HexabitzPlatform/HF091CBU-Hardware/README.md

# HF091CBU-Hardware
Hexabitz STM32F091CBU6 DevKit Hardware Design
