HexabitzPlatform/HF091CBU-Hardware/Released/BOM/HF091CBU.xlsx

 |  | www.hexabitz.com info@hexabitz.com |  | Bill Of Materials
Customer | Hexabitz | Revision | 0
Project | Hexabitz Modules | Date | 2024-05-27
Board | STM32F091CBU6 DevKit | Notes
Designator | Description | Manufacturer Part Number | Manufacturer | Octopart Url | Quantity
BOOT, RESET | Switch Tactile N.O. SPST Round Button PC Pins 0.05A 12VDC 100000Cycle 1.27N Thru-Hole Bulk | PTS645SL43LFS | C&K Components | https://octopart.com/pts645sl43lfs-c%26k+components-7881901?r=sp | 2
SWD | Connector Header Through Hole, Right Angle 5 position 0.100" (2.54mm) | M20-9960245 | Harwin | https://octopart.com/m20-9960245-harwin-14865948?r=sp | 1
JP_L, JP_R | Connector Header Through Hole 20 position 0.100" (2.54mm) | M20-9992046 | Harwin | https://octopart.com/m20-9992046-harwin-2627752 | 2
USB_MICRO | USB Connector, 5 Contact(s), Female, Right Angle, Surface Mount Terminal, Locking, Receptacle | 629105136821 | Wurth Elektronik | https://octopart.com/629105136821-wurth+elektronik-19991173?r=sp | 1
R3 | RES SMD 0.0OHM JUMPER 1/10W 0603 | RC0603JR-070RL | YAGEO [VR] | https://octopart.com/rc0603jr-070rl-yageo-1241539?r=sp | 1
R4, R5 | Thick Film Resistors - SMD 0603 1/10W 1% 27R T/R-5000 | 0603WAF270JT5E | Royal Ohm | https://octopart.com/0603waf270jt5e-royal+ohm-127860643?r=sp | 2
R1 | Thick Film Resistors - SMD 0603 270 Ohm 5% Tol | ERJ-3GEYJ271V | Panasonic | https://octopart.com/erj-3geyj271v-panasonic-55560546?r=sp | 1
R2, R10, R11 | RES 10K Ohm 5% 0603 | CRCW060310K0JNEB | Vishay | https://octopart.com/crcw060310k0jneb-vishay-46603269 | 3
C13, C14 | CAP CER 47pF 10% X7R 0603 | VJ0603A470JXACW1BC | Vishay | https://octopart.com/vj0603a470jxacw1bc-vishay-39475596?r=sp | 2
C5, C17 | Multilayer Ceramic Capacitor, 0.01 uF, 50 V, ± 10%, X7R, 0603 [1608 Metric] | C0603C103K5RACTU | KEMET | https://octopart.com/c0603c103k5ractu-kemet-133094?r=sp | 2
C1, C6, C7, C8, C9, C11, C12, C15, C16, C18 | CAP CER 0.1 UF 10% X7R 0603 | C0603C104K8RACTU | KEMET | https://octopart.com/c0603c104k8ractu-kemet-145075?r=sp&s=9bS9ASSwSEqMCE9KBEQZ0g | 10
C2 | CAP CER 1 UF 16V X7R 0805 | CC0805KKX7R7BB105 | YAGEO [VA] | https://octopart.com/cc0805kkx7r7bb105-yageo-8376555?r=sp | 1
C10 | CAP CER 4.7uF 10% X7R 0805 | 10TPU4R7MSI | Panasonic | https://octopart.com/10tpu4r7msi-panasonic-29487748?r=sp | 1
C3, C4 | CAP TANT 4.7 UF 10V 20% 0805 | 10TPU4R7MSI | Panasonic | https://octopart.com/10tpu4r7msi-panasonic-29487748?r=sp | 2
FB1, FB2 | Ind chip Bead Multi-Layer 30 ohms 25% 100MHZ Ferrite 1,5A 0603Punched paper T/R | MMZ1608Y300BTA00 | TDK | https://octopart.com/mmz1608y300bta00-tdk-7906990?r=sp | 2
D1 | Red 0603 130° Clear 54 mcd 2 V Surface Mount ChipLED | VLMS1300-GS08 | Vishay | https://octopart.com/vlms1300-gs08-vishay-21709201?r=sp&s=0nXJNjGsSbWwqfqWlZv0EA | 1
D4 | Diode Switching 1KV 1A 2-Pin SOD-123FL T/R | FSM17PL-TP | MCC | https://octopart.com/fsm17pl-tp-mcc-57606818?r=sp | 1
U1 | MCU 32-bit ARM Cortex M0 RISC 128KB Flash 2.5V/3.3V 48-Pin UFQFPN EP Frame | STM32F091CBU6 | STMicroelectronics | https://octopart.com/stm32f091cbu6-stmicroelectronics-51988677?r=sp | 1
U2 | USB-to-UART 1-CH 256Byte FIFO 5V 32-Pin QFN EP Check availability | FT232RQ |  | https://www.alibaba.com/product-detail/Ft232hl-Ft232h-Ft232-Ftdi-Qfp48-Usb_1600809369606.html | 1
X1 | 8,0000MHZ 33pF SMD MURATA Resonators | CSTNE8M00G550000R0 | Murata | https://octopart.com/cstne8m00g550000r0-murata-91406934?r=sp | 1
