HexabitzPlatform/HF091CBU-Hardware/Documintation/HF091CBU_Schematic.pdf

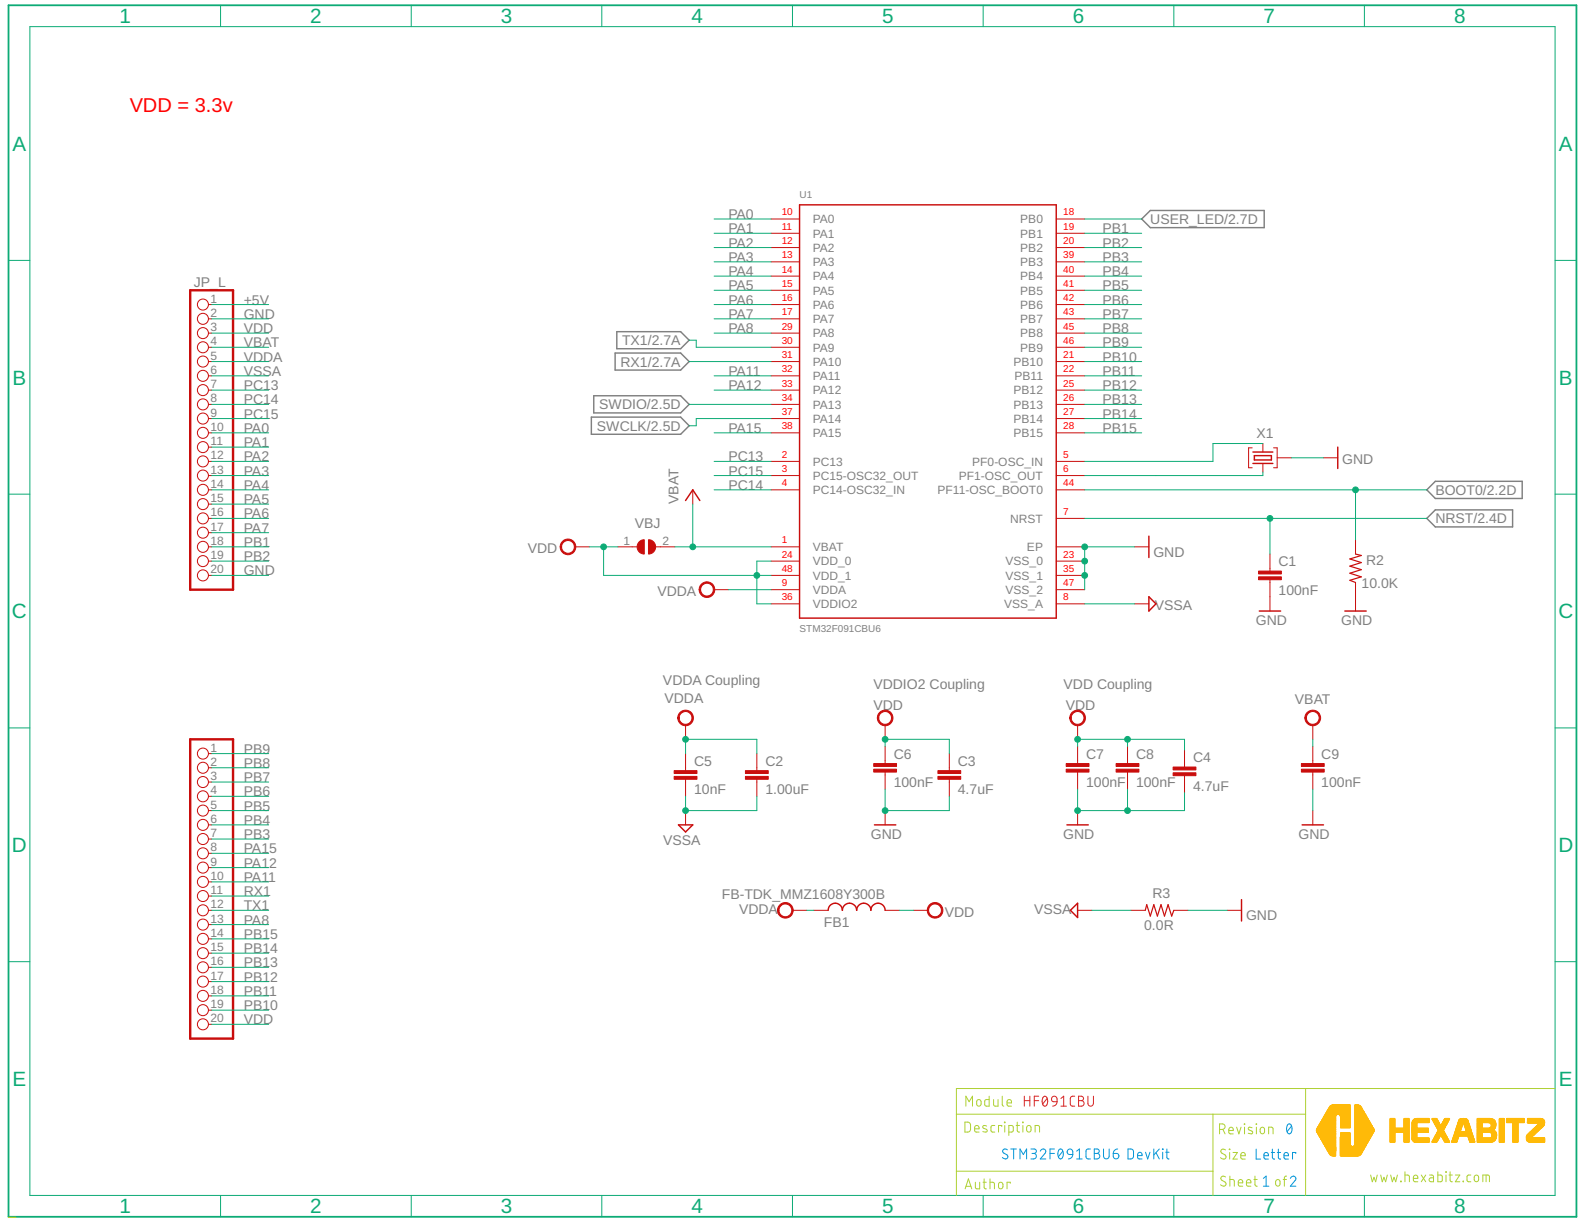
[picture p1: page 1]

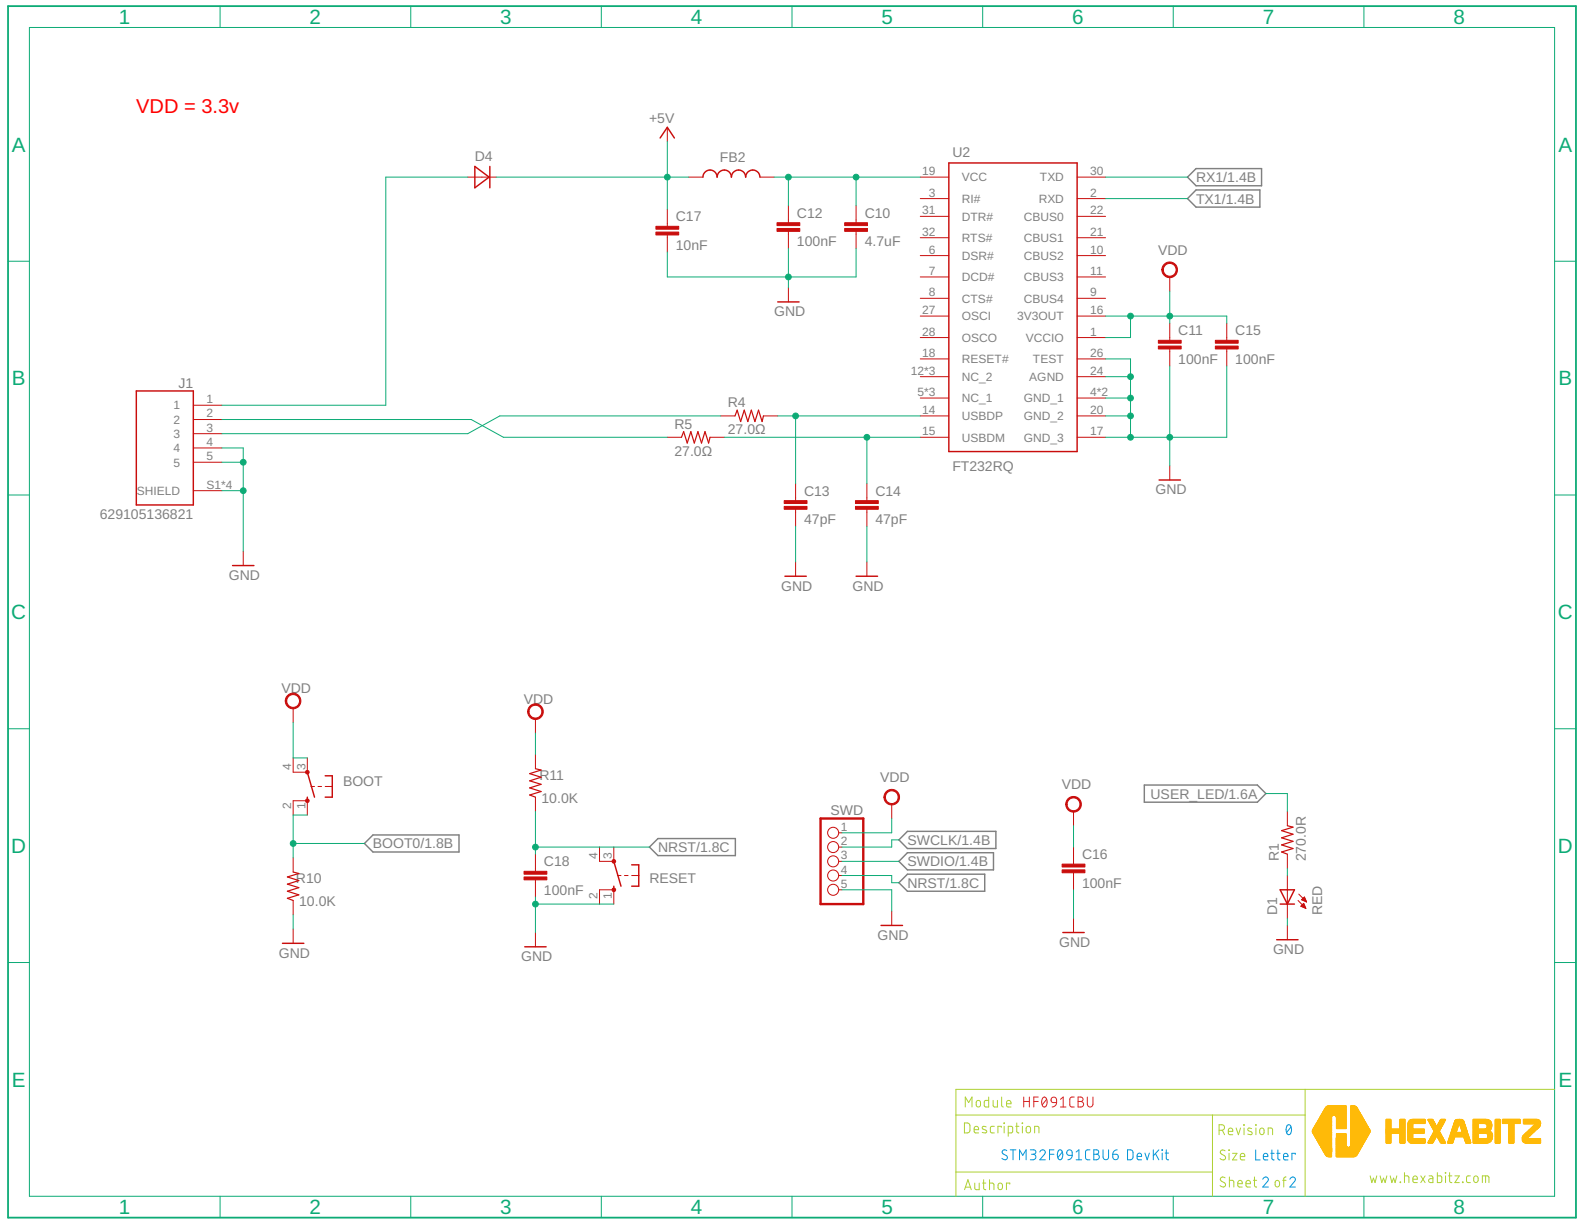
[picture p2: page 2]

VDD = 3.3v
