HexabitzPlatform/HF091CBU-Hardware/Design/HF091CBU.brd

## EAGLE design Design/HF091CBU.brd (2024-09-10)

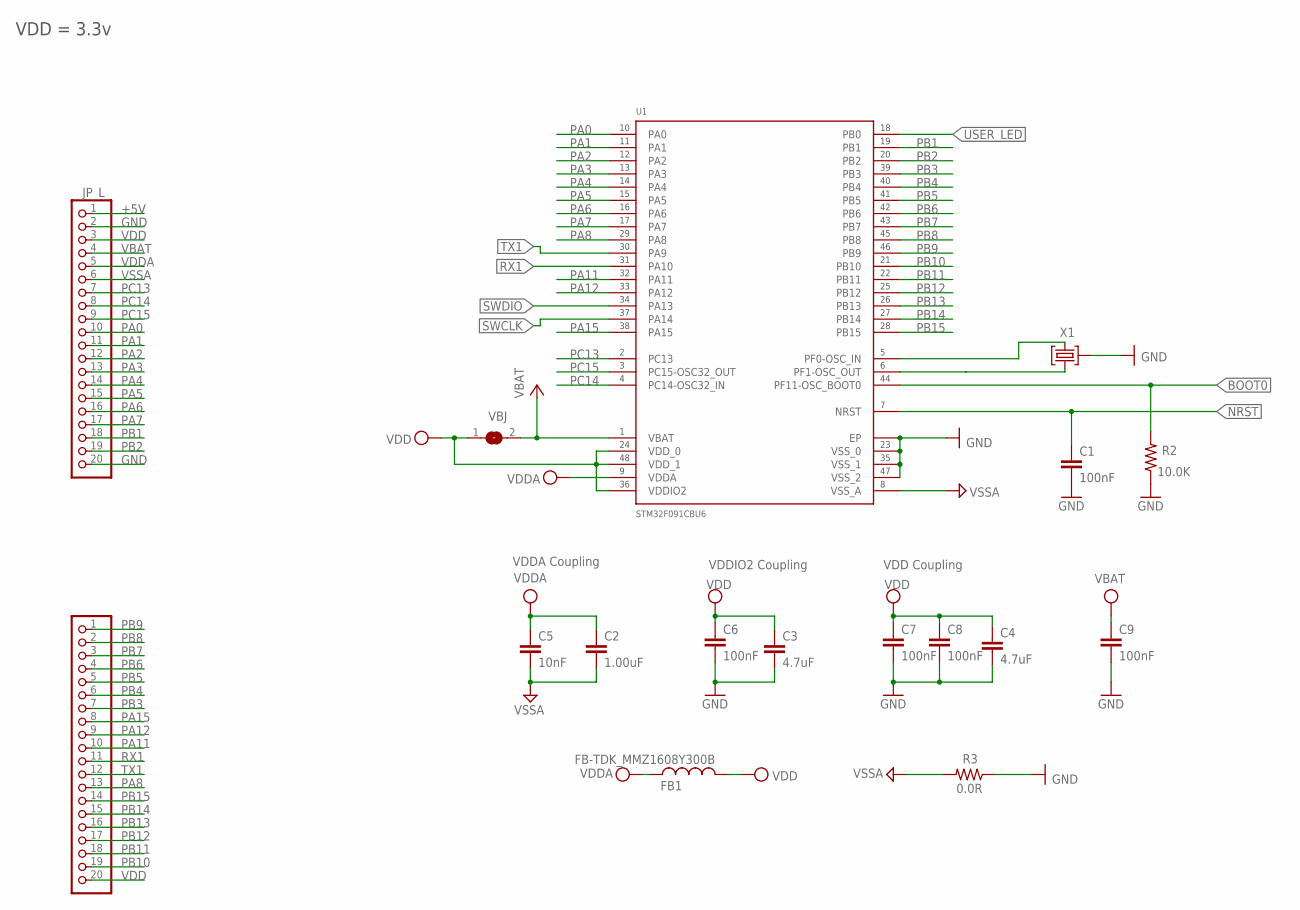
[picture p3: schematic HF091CBU.sch, sheet 1]

Parts:
C1, C6, C8: 100nF; C-0603; TOLERANCE 10%; VOLTAGE_RATING 10V; MPN C0603C104K8RACTU
C2: 1.00uF; C-0805
C3, C4: 4.7uF; C-0805
C5: 10nF; C-0603; TOLERANCE 10%; VOLTAGE_RATING 50V; MPN C0603C103K5RACTU
C7: 100nF; C-0603; TOLERANCE 10%; VOLTAGE_RATING 10; MPN C0603C104K8RACTU
C9: 100nF; C-0603; TOLERANCE 10V; VOLTAGE_RATING 10%; MPN C0603C104K8RACTU
FB1: FB-TDK_MMZ1608Y300B; FB-0603; MPN MMZ1608Y300B
JP_L: PINHD-1X20; 1X20
JP_R: PINHD-1X20; 1X20
R2: 10.0K; R-0603; TOLERANCE 5%; MPN CRCW060310K0JNEB
R3: 0.0R; R-0603; MPN RC0603JR-070RL
U1: STM32F091CBU6
VBJ: SJ
X1: XTALL_CSTCE8M00G52

Connections:
+5V: JP_L.1; also elsewhere on the board
BOOT0: R2.2, U1.P$44 (PF11-OSC_BOOT0); also elsewhere on the board
GND: C1.2, C3.2, C4.2, C6.2, C7.2, C8.2, C9.2, JP_L.2, JP_L.20, R2.1, R3.1, U1.EP, U1.P$23 (VSS_0), U1.P$35 (VSS_1), U1.P$47 (VSS_2), X1.P$2 (2); also elsewhere on the board
unnamed: U1.P$5 (PF0-OSC_IN), X1.P$1 (1)
unnamed: U1.P$6 (PF1-OSC_OUT), X1.P$3 (3)
NRST: C1.1, U1.P$7 (NRST); also elsewhere on the board
PA0: JP_L.10, U1.P$10 (PA0)
PA1: JP_L.11, U1.P$11 (PA1)
PA2: JP_L.12, U1.P$12 (PA2)
PA3: JP_L.13, U1.P$13 (PA3)
PA4: JP_L.14, U1.P$14 (PA4)
PA5: JP_L.15, U1.P$15 (PA5)
PA6: JP_L.16, U1.P$16 (PA6)
PA7: JP_L.17, U1.P$17 (PA7)
PA8: JP_R.13, U1.P$29 (PA8)
PA11: JP_R.10, U1.P$32 (PA11)
PA12: JP_R.9, U1.P$33 (PA12)
PA15: JP_R.8, U1.P$38 (PA15)
PB1: JP_L.18, U1.P$19 (PB1)
PB2: JP_L.19, U1.P$20 (PB2)
PB3: JP_R.7, U1.P$39 (PB3)
PB4: JP_R.6, U1.P$40 (PB4)
PB5: JP_R.5, U1.P$41 (PB5)
PB6: JP_R.4, U1.P$42 (PB6)
PB7: JP_R.3, U1.P$43 (PB7)
PB8: JP_R.2, U1.P$45 (PB8)
PB9: JP_R.1, U1.P$46 (PB9)
PB10: JP_R.19, U1.P$21 (PB10)
PB11: JP_R.18, U1.P$22 (PB11)
PB12: JP_R.17, U1.P$25 (PB12)
PB13: JP_R.16, U1.P$26 (PB13)
PB14: JP_R.15, U1.P$27 (PB14)
PB15: JP_R.14, U1.P$28 (PB15)
PC13: JP_L.7, U1.P$2 (PC13)
PC14: JP_L.8, U1.P$3 (PC14-OSC32_IN)
PC15: JP_L.9, U1.P$4 (PC15-OSC32_OUT)
RX1: JP_R.11, U1.P$31 (PA10); also elsewhere on the board
SWCLK: U1.P$37 (PA14); also elsewhere on the board
SWDIO: U1.P$34 (PA13); also elsewhere on the board
TX1: JP_R.12, U1.P$30 (PA9); also elsewhere on the board
USER_LED: U1.P$18 (PB0); also elsewhere on the board
VBAT: C9.1, JP_L.4, U1.P$1 (VBAT), VBJ.2
VDD: C3.1, C4.1, C6.1, C7.1, C8.1, FB1.2, JP_L.3, JP_R.20, U1.P$24 (VDD_0), U1.P$36 (VDDIO2), U1.P$48 (VDD_1), VBJ.1; also elsewhere on the board
VDDA: C2.1, C5.1, FB1.1, JP_L.5, U1.P$9 (VDDA)
VSSA: C2.2, C5.2, JP_L.6, R3.2, U1.P$8 (VSS_A)

Notes on the sheet:
VDDA Coupling
VDDIO2 Coupling
VDD Coupling
VDD = 3.3v

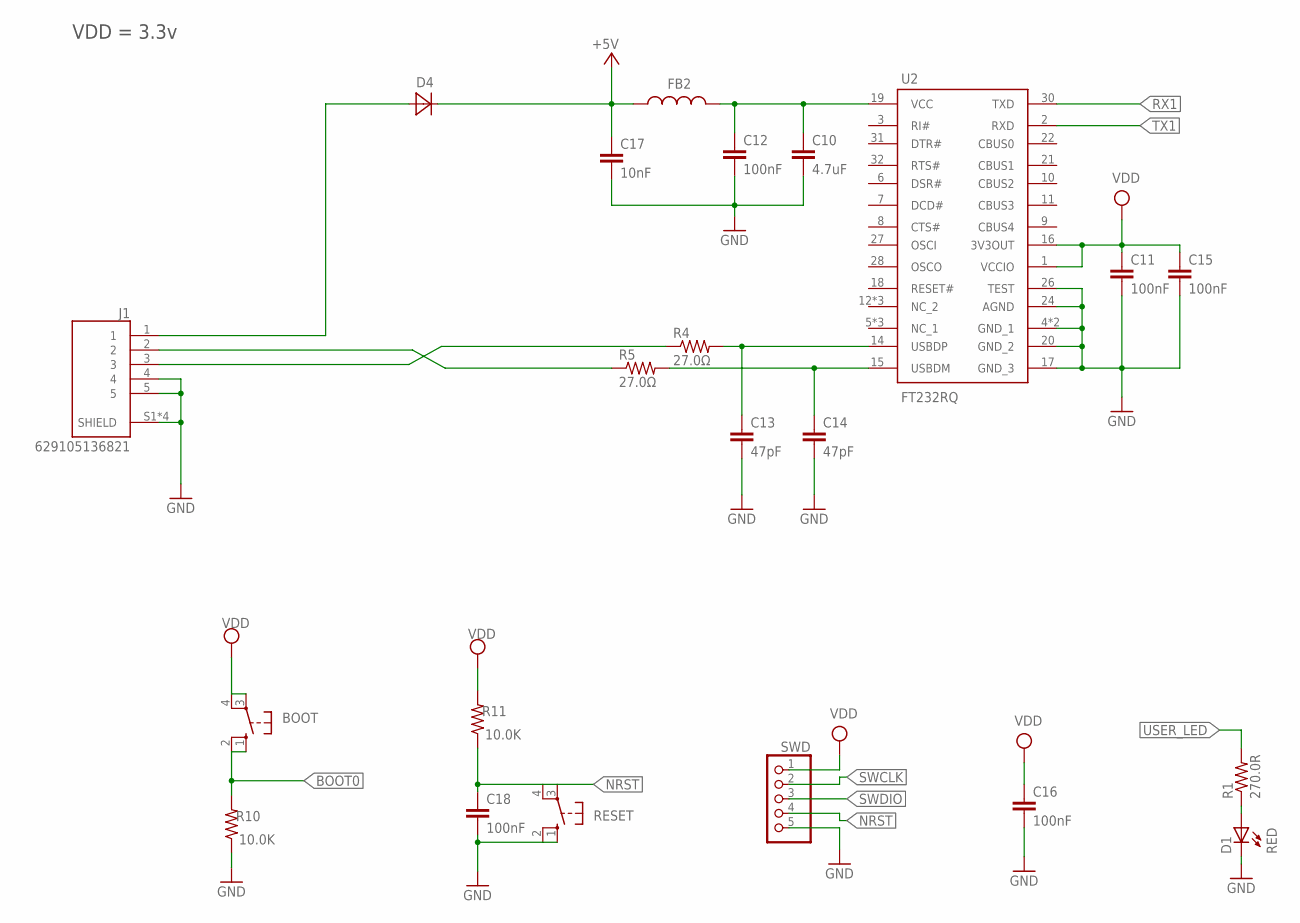
[picture p4: schematic HF091CBU.sch, sheet 2]

Parts:
BOOT: 10-XX; B3F-10XX
C10: 4.7uF; C-0805
C11, C12, C15: 100nF; C-0603; TOLERANCE ±10%; VOLTAGE_RATING 16.0 V; MPN 0603YC104K4T2A
C13, C14: 47pF; C-0603; TOLERANCE ±5%; VOLTAGE_RATING 50.0 V; MPN 06035A470JAT2A
C16, C18: 100nF; C-0603; TOLERANCE 10%; VOLTAGE_RATING 10V; MPN C0603C104K8RACTU
C17: 10nF; C-0603; TOLERANCE ±10%; VOLTAGE_RATING 16.0 V; MPN 0603YC104K4T2A
D1: RED; VLMS1300-GS08; MPN VLMS1300-GS08
D4: DIOD-SOD-123; SOD123
FB2: FB-TDK_MMZ1608Y300B; FB-0603; MPN MMZ1608Y300B
J1: 629105136821; WE_629105136821
R1: 270.0R; R-0603; TOLERANCE 1%; MPN RC0603FR-07270RL
R4, R5: 27.0Ω; R-0603; TOLERANCE ±1%; MPN CRCW060327R0FKEA
R10, R11: 10.0K; R-0603; TOLERANCE 5%; MPN RC0603JR-0710KL
RESET: 10-XX; B3F-10XX
SWD: PINHD-1X5/90; 1X05/90
TRIMBLE-LOGO1: HEXABITZ-LOGO_NO_BOTTOM_SPLIT
U2: FT232RQ; QFN50P500X500X90-33N

Connections:
+5V: C17.1, D4.2 (C), FB2.1; also elsewhere on the board
BOOT0: BOOT.1 (S), BOOT.2 (S1), R10.2; also elsewhere on the board
GND: C10.2, C11.2, C12.2, C13.2, C14.2, C15.2, C16.2, C17.2, C18.2, D1.C, J1.4, J1.5, J1.S1 (SHIELD), J1.S2 (SHIELD), J1.S3 (SHIELD), J1.S4 (SHIELD), R10.1, RESET.1 (S), RESET.2 (S1), SWD.5, U2.4 (GND_1), U2.17 (GND_3), U2.20 (GND_2), U2.24 (AGND), U2.26 (TEST), U2.33 (GND_1); also elsewhere on the board
unnamed: D4.1 (A), J1.1
unnamed: C10.1, C12.1, FB2.2, U2.19 (VCC)
unnamed: D1.A, R1.1
NRST: C18.1, R11.1, RESET.3, RESET.4 (P1), SWD.4; also elsewhere on the board
RX1: U2.30 (TXD); also elsewhere on the board
SWCLK: SWD.2; also elsewhere on the board
SWDIO: SWD.3; also elsewhere on the board
TX1: U2.2 (RXD); also elsewhere on the board
USBD_N: C14.1, R5.2, U2.15 (USBDM)
USBD_P: C13.1, R4.2, U2.14 (USBDP)
USB_N: J1.2, R5.1
USB_P: J1.3, R4.1
USER_LED: R1.2; also elsewhere on the board
VDD: BOOT.3, BOOT.4 (P1), C11.1, C15.1, C16.1, R11.2, SWD.1, U2.1 (VCCIO), U2.16 (3V3OUT); also elsewhere on the board

Notes on the sheet:
VDD = 3.3v

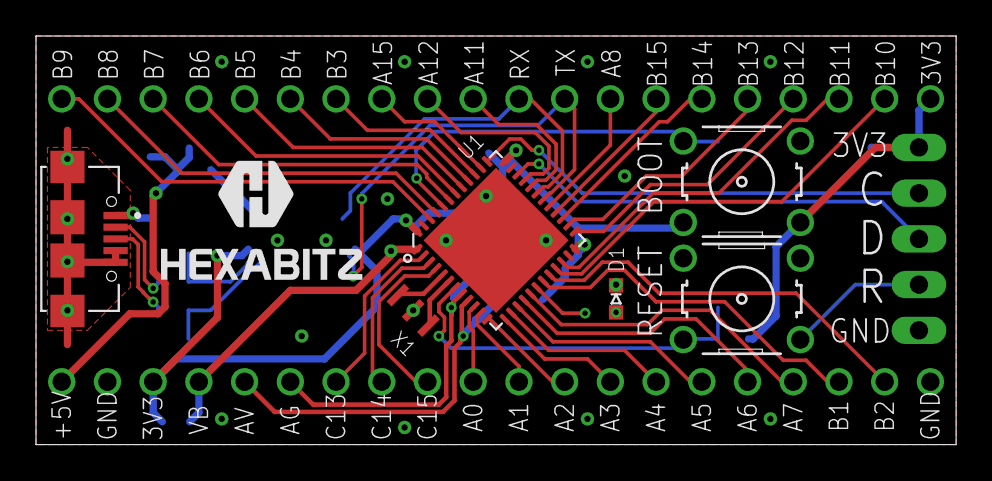
[picture p5: board HF091CBU.brd from above]

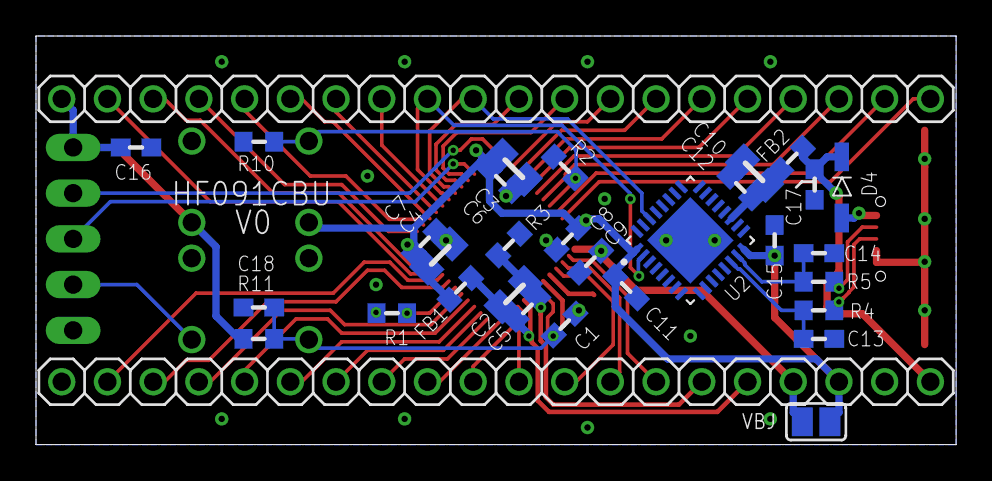
[picture p6: board HF091CBU.brd from below]

Board: 2 copper layers, 51.1 x 22.7 mm, 40 parts (30 on the bottom side), 52 nets.
