HexabitzPlatform/HF091CBU-Hardware/(commit log)

2024-05-21 Make the tamplete Unchecked schematic
    [H1AR30.xlsx, HF091CBU.brd, HF091CBU.sch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]
2024-07-15 All finish, reviewed version
    [HF091CBU.sch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]
2024-09-10 -Fixing an issue on the silkscreen layer
    [HF091CBU.brd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]
2024-09-14 Update the BOM but still need check
    [H1AR30.xlsx, HF091CBU.xlsx]
